OulanB/P4VGA565/EasyEDA_Pro/3D_PCB1_2026-03-03.png

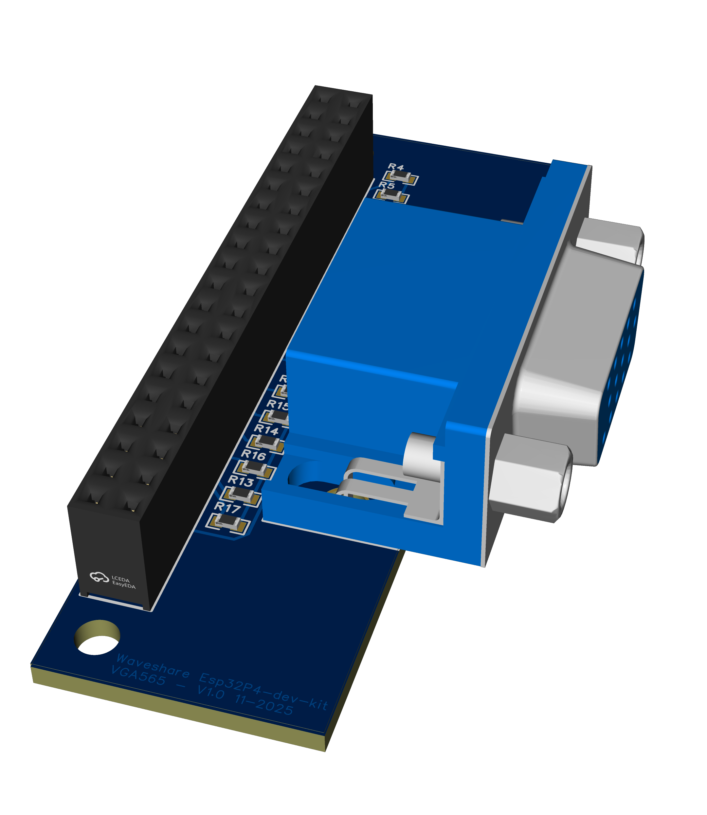
EasyEDA_Pro/3D_PCB1_2026-03-03.png
