OulanB/P4VGA565/EasyEDA_Pro/7ec9b065-7789-4629-8614-c2b59bddfc5a.pdf

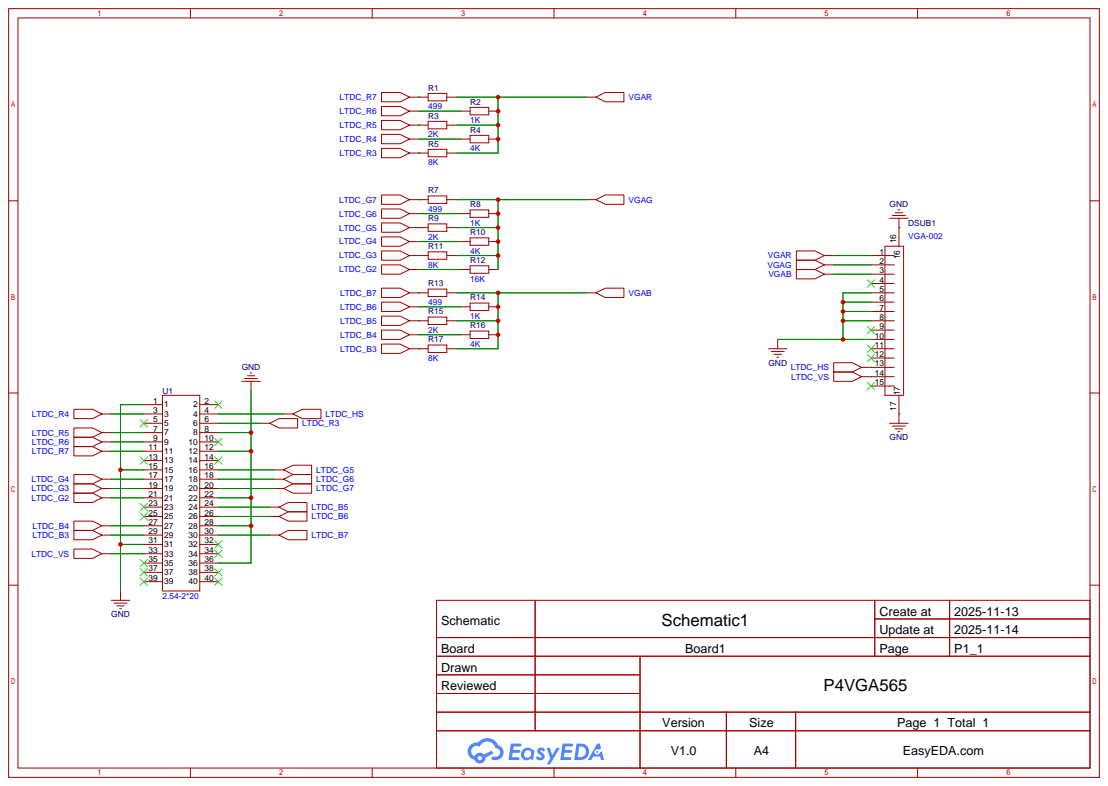
[picture p3: page 1]

Schematic | Schematic1 | Create at | 2025-11-13

Update at | 2025-11-14

Board | Board1 | Page | P1_1
Drawn | | P4VGA565
Reviewed
