OulanB/P4VGA565/(list of files, drawings)

Other design files:
EasyEDA_Pro/P4VGA565.eprj
