OulanB/P4VGA565/(commit log)

2026-03-03 Update README with ESP32-P4 project information
    Added project details and specifications for the WaveShare ESP32-P4-WIFI6-DEV-KIT board.
2026-03-03 Fix typo in README for WaveShare board
2026-03-04 Update README with schematic and IO details
    Added notes about schematic details and IO usage.
2026-03-05 Update README with Bug 2 correction details
    Corrected Bug 2 details and added correction steps for the hardware issue with the red channel gradient display. Updated pin connections for improved LDO functionality.
2026-03-05 Update README with USB C port and red channel issues
    Added detailed analysis regarding the red channel defect and proposed changes to GPIO connections for better LDO voltage management.
